JoeParker18/RECLAIM/SMELT SOP.docx

RECLAIM SMELT Standard Operating Procedure

- Sand Cast Creation
1. The sand cast must be made using a mixture of 200g of ilmenite, 6g of water (Tap water is fine) and 3g of sodium silicate.
2. Once this mixture has been made, a piece for a mold should be picked out that is weighed and material identified to allow for a precise calculation accounting for losses to predict the amount of input feedstock needed.
3. The drag of the sand cast is filled sand then the mold is placed into the drag to create a mold outline. The cope is then placed over the drag aligning with the holes of the drag and the sprue and riser are placed on opposing ends of your mold piece and sand is packed in tight to finish the sand cast.
4. The cope and drag must be pulled apart to remove the piece for the mold and then realign the cope and drag to finish the sand cast
- Running SMELT
1. Prior to any testing, there must be a run done at 500-1000 W to check microwave leakage using a leakage sensor following around the entire perimeter to ensure leakage levels are below 25 mW/cm³
2. Once the leakage has been confirmed to be below that threshold, the sand cast must be placed below the chamber and align the sprue hole with the hole at the base of the chamber using a stick for alignment for now until the drawer is attached to the chamber bottom.
3. Next, the crucible must be wrapped in ceramic fiber and Kapton tape to create a thickness of 1.25 inches on just the sides. A top must also be created with a hole at the center going straight into the crucible for the mullite tube to deliver the aluminum.
4. After properly insulating the crucible, the crucible will be placed in the chamber and aligned with the chamber hole to allow flow of molten aluminum from the crucible to the sand cast mold.
5. The top of the insulation is placed onto the crucible and the mullite tube is aligned with the hole in it as well as the lid being placed on top
  a. The lid must be clamped down to ensure no microwave leakage
6. The system can now be turned on with 1000W being fed through the waveguide connection for 5 minutes to preheat the crucible
  a. This is to reduce the oxidation that occurs when the aluminum starts to melt
7. Once the 5 minutes have passed, aluminum shreds will be dropped down the mullite tube into the crucible and the IR sensor placed to look down into the crucible
8. The system will run at 2-3 kW depending on the test being performed for 3 minutes
9. After the 3 minutes have passed, the SSMG is to be turned off and the vibrator is turned on for 1 second with the tip being wrapped in two hand towels against the structure holding the chamber up.
