JoeParker18/RECLAIM/assembled_chamber.step

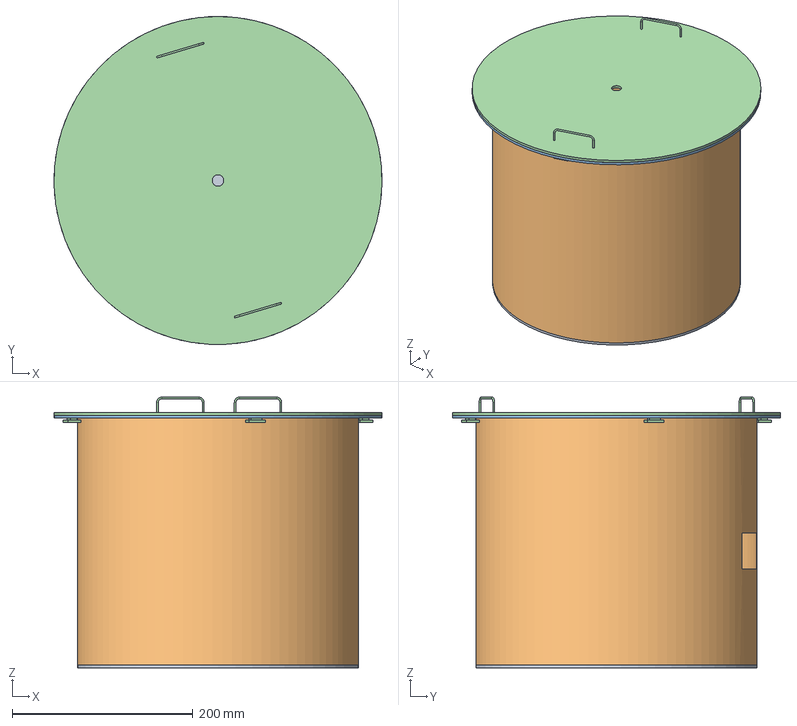
[picture p48: CAD file, 2026-10-17, last stored version]
assembled_chamber.step
362.7 x 362.8 x 299.5 mm
Just the top of the lid
Just the top of the lid_1
SSPL_Chamber_Phase 3
